dcpedit/midevil/pcb/README.md

# MidEvil PCB

midevil-pcb
