dcpedit/midevil/pcb/pcb.kicad_sch

## KiCad design pcb/pcb.kicad_sch (2023-09-18)

Schematic: pcb.kicad_sch

Parts:
D1, D2, D3, D4, D5, D6, D7, D8, D9, D10, D11, D12, D13, D14, D15, D16, D17, D18, D19, D20, D21, D22, D23, D24, D25, D26, D27, D28, D29, D30, D31, D32, D33, D34, D35, D36, D37, D38, D39, D40, D41, D42, D43, D44, D45, D46, D47, D48: BAV70; SOT-23_Handsoldering
J1: Conn_01x08_Socket
MX00, MX01, MX02, MX03, MX04, MX05, MX06, MX07, MX08, MX09, MX09.1, MX10, MX11, MX12, MX13, MX14, MX15, MX16, MX17, MX18, MX19, MX19.1, MX20, MX20.125, MX21, MX22, MX23, MX24, MX25, MX26, MX27, MX28, MX28.2, MX29, MX30, MX30.125, MX31, MX32, MX33, MX34, MX35, MX36, MX37, MX38, MX38.125, MX39, MX40, MX41, MX42, MX42.225, MX43, MX44, MX45, MX46, MX47, MX48, MX49, MX50, MX51, MX52, MX53, MX54, MX55, MX56, MX57, MX58, MX59, MX60, MX61, MX62, MX63, MX64, MX64.1, MX65, MX66, MX67, MX69, MX70, MX71, MX72, MX73, MX74, MX75, MX76, MX77, MX78, MX79, MX80, MX81, MX82, MX83, MX84, MX84.1, MX85, MX86, MX87, MX90, MX91, MX91.1, MX92, MX93, MX93.1, MX94, MX95, MX96, MX97: MX-NoLED; MXOnly-1U-NoLED
U1: Pico; RPi_Pico_SMD_TH

Connections:
+5V: J1.8, U1.40 (VBUS)
COL0: MX00.1 (COL), MX10.1 (COL), MX20.1 (COL), MX20.125.1 (COL), MX30.1 (COL), MX30.125.1 (COL), MX40.1 (COL), MX50.1 (COL), MX60.1 (COL), MX70.1 (COL), MX80.1 (COL), MX90.1 (COL), U1.32 (GPIO27_ADC1)
COL1: MX01.1 (COL), MX11.1 (COL), MX21.1 (COL), MX31.1 (COL), MX41.1 (COL), MX51.1 (COL), MX61.1 (COL), MX71.1 (COL), MX81.1 (COL), MX91.1 (COL), MX91.1.1 (COL), U1.34 (GPIO28_ADC2)
COL2: MX02.1 (COL), MX12.1 (COL), MX22.1 (COL), MX32.1 (COL), MX42.1 (COL), MX42.225.1 (COL), MX52.1 (COL), MX62.1 (COL), MX72.1 (COL), MX82.1 (COL), MX92.1 (COL), U1.15 (GPIO11)
COL3: MX03.1 (COL), MX13.1 (COL), MX23.1 (COL), MX33.1 (COL), MX43.1 (COL), MX53.1 (COL), MX63.1 (COL), MX73.1 (COL), MX83.1 (COL), MX93.1 (COL), MX93.1.1 (COL), U1.14 (GPIO10)
COL4: MX04.1 (COL), MX14.1 (COL), MX24.1 (COL), MX34.1 (COL), MX44.1 (COL), MX54.1 (COL), MX64.1 (COL), MX64.1.1 (COL), MX74.1 (COL), MX84.1 (COL), MX84.1.1 (COL), MX94.1 (COL), U1.12 (GPIO9)
COL5: MX05.1 (COL), MX15.1 (COL), MX25.1 (COL), MX35.1 (COL), MX45.1 (COL), MX55.1 (COL), MX65.1 (COL), MX75.1 (COL), MX85.1 (COL), MX95.1 (COL), U1.6 (GPIO4)
COL6: MX06.1 (COL), MX16.1 (COL), MX26.1 (COL), MX36.1 (COL), MX46.1 (COL), MX56.1 (COL), MX66.1 (COL), MX76.1 (COL), MX86.1 (COL), MX96.1 (COL), U1.5 (GPIO3)
COL7: MX07.1 (COL), MX17.1 (COL), MX27.1 (COL), MX37.1 (COL), MX47.1 (COL), MX57.1 (COL), MX67.1 (COL), MX77.1 (COL), MX87.1 (COL), MX97.1 (COL), U1.4 (GPIO2)
COL8: MX08.1 (COL), MX18.1 (COL), MX28.1 (COL), MX28.2.1 (COL), MX38.1 (COL), MX38.125.1 (COL), MX48.1 (COL), MX58.1 (COL), MX78.1 (COL), U1.2 (GPIO1)
COL9: MX09.1 (COL), MX09.1.1 (COL), MX19.1 (COL), MX19.1.1 (COL), MX29.1 (COL), MX39.1 (COL), MX49.1 (COL), MX59.1 (COL), MX69.1 (COL), MX79.1 (COL), U1.1 (GPIO0)
GND: J1.7, U1.3 (GND), U1.8 (GND), U1.13 (GND), U1.18 (GND), U1.23 (GND), U1.28 (GND), U1.38 (GND), U1.42 (GND)
LCD_CS: J1.6, U1.22 (GPIO17)
LCD_DC: J1.4, U1.21 (GPIO16)
LCD_LED: J1.1, U1.20 (GPIO15)
LCD_RST: J1.5, U1.19 (GPIO14)
LCD_SCK: J1.2, U1.24 (GPIO18)
LCD_SDA: J1.3, U1.25 (GPIO19)
unnamed: D1.1 (A), MX00.2 (ROW)
unnamed: D1.2 (A), MX01.2 (ROW)
unnamed: D2.1 (A), MX10.2 (ROW)
unnamed: D2.2 (A), MX11.2 (ROW)
unnamed: D3.1 (A), MX20.2 (ROW), MX20.125.2 (ROW)
unnamed: D3.2 (A), MX21.2 (ROW)
unnamed: D4.1 (A), MX30.2 (ROW), MX30.125.2 (ROW)
unnamed: D4.2 (A), MX31.2 (ROW)
unnamed: D5.1 (A), MX40.2 (ROW)
unnamed: D5.2 (A), MX41.2 (ROW)
unnamed: D6.1 (A), MX50.2 (ROW)
unnamed: D6.2 (A), MX51.2 (ROW)
unnamed: D7.1 (A), MX60.2 (ROW)
unnamed: D7.2 (A), MX61.2 (ROW)
unnamed: D8.1 (A), MX70.2 (ROW)
unnamed: D8.2 (A), MX71.2 (ROW)
unnamed: D9.1 (A), MX80.2 (ROW)
unnamed: D9.2 (A), MX81.2 (ROW)
unnamed: D10.1 (A), MX90.2 (ROW)
unnamed: D10.2 (A), MX91.2 (ROW), MX91.1.2 (ROW)
unnamed: D11.1 (A), MX02.2 (ROW)
unnamed: D11.2 (A), MX03.2 (ROW)
unnamed: D12.1 (A), MX12.2 (ROW)
unnamed: D12.2 (A), MX13.2 (ROW)
unnamed: D13.1 (A), MX22.2 (ROW)
unnamed: D13.2 (A), MX23.2 (ROW)
unnamed: D14.1 (A), MX32.2 (ROW)
unnamed: D14.2 (A), MX33.2 (ROW)
unnamed: D15.1 (A), MX42.2 (ROW), MX42.225.2 (ROW)
unnamed: D15.2 (A), MX43.2 (ROW)
unnamed: D16.1 (A), MX52.2 (ROW)
unnamed: D16.2 (A), MX53.2 (ROW)
unnamed: D17.1 (A), MX62.2 (ROW)
unnamed: D17.2 (A), MX63.2 (ROW)
unnamed: D18.1 (A), MX72.2 (ROW)
unnamed: D18.2 (A), MX73.2 (ROW)
unnamed: D19.1 (A), MX82.2 (ROW)
unnamed: D19.2 (A), MX83.2 (ROW)
unnamed: D20.1 (A), MX92.2 (ROW)
unnamed: D20.2 (A), MX93.2 (ROW), MX93.1.2 (ROW)
unnamed: D21.1 (A), MX04.2 (ROW)
unnamed: D21.2 (A), MX05.2 (ROW)
unnamed: D22.1 (A), MX14.2 (ROW)
unnamed: D22.2 (A), MX15.2 (ROW)
unnamed: D23.1 (A), MX24.2 (ROW)
unnamed: D23.2 (A), MX25.2 (ROW)
unnamed: D24.1 (A), MX34.2 (ROW)
unnamed: D24.2 (A), MX35.2 (ROW)
unnamed: D25.1 (A), MX44.2 (ROW)
unnamed: D25.2 (A), MX45.2 (ROW)
unnamed: D26.1 (A), MX54.2 (ROW)
unnamed: D26.2 (A), MX55.2 (ROW)
unnamed: D27.1 (A), MX64.2 (ROW), MX64.1.2 (ROW)
unnamed: D27.2 (A), MX65.2 (ROW)
unnamed: D28.1 (A), MX74.2 (ROW)
unnamed: D28.2 (A), MX75.2 (ROW)
unnamed: D29.1 (A), MX84.2 (ROW), MX84.1.2 (ROW)
unnamed: D29.2 (A), MX85.2 (ROW)
unnamed: D30.1 (A), MX94.2 (ROW)
unnamed: D30.2 (A), MX95.2 (ROW)
unnamed: D31.1 (A), MX06.2 (ROW)
unnamed: D31.2 (A), MX07.2 (ROW)
unnamed: D32.1 (A), MX16.2 (ROW)
unnamed: D32.2 (A), MX17.2 (ROW)
unnamed: D33.1 (A), MX26.2 (ROW)
unnamed: D33.2 (A), MX27.2 (ROW)
unnamed: D34.1 (A), MX36.2 (ROW)
unnamed: D34.2 (A), MX37.2 (ROW)
unnamed: D35.1 (A), MX46.2 (ROW)
unnamed: D35.2 (A), MX47.2 (ROW)
unnamed: D36.1 (A), MX56.2 (ROW)
unnamed: D36.2 (A), MX57.2 (ROW)
unnamed: D37.1 (A), MX66.2 (ROW)
unnamed: D37.2 (A), MX67.2 (ROW)
unnamed: D38.1 (A), MX76.2 (ROW)
unnamed: D38.2 (A), MX77.2 (ROW)
unnamed: D39.1 (A), MX86.2 (ROW)
unnamed: D39.2 (A), MX87.2 (ROW)
unnamed: D40.1 (A), MX96.2 (ROW)
unnamed: D40.2 (A), MX97.2 (ROW)
unnamed: D41.1 (A), MX08.2 (ROW)
unnamed: D41.2 (A), MX09.2 (ROW), MX09.1.2 (ROW)
unnamed: D42.1 (A), MX18.2 (ROW)
unnamed: D42.2 (A), MX19.2 (ROW), MX19.1.2 (ROW)
unnamed: D43.1 (A), MX28.2 (ROW), MX28.2.2 (ROW)
unnamed: D43.2 (A), MX29.2 (ROW)
unnamed: D44.1 (A), MX38.2 (ROW), MX38.125.2 (ROW)
unnamed: D44.2 (A), MX39.2 (ROW)
unnamed: D45.1 (A), MX48.2 (ROW)
unnamed: D45.2 (A), MX49.2 (ROW)
unnamed: D46.1 (A), MX58.2 (ROW)
unnamed: D46.2 (A), MX59.2 (ROW)
unnamed: D47.2 (A), MX69.2 (ROW)
unnamed: D48.1 (A), MX78.2 (ROW)
unnamed: D48.2 (A), MX79.2 (ROW)
ROW0: D1.3 (K), D11.3 (K), D21.3 (K), D31.3 (K), D41.3 (K), U1.9 (GPIO6)
ROW1: D2.3 (K), D12.3 (K), D22.3 (K), D32.3 (K), D42.3 (K), U1.11 (GPIO8)
ROW2: D3.3 (K), D13.3 (K), D23.3 (K), D33.3 (K), D43.3 (K), U1.17 (GPIO13)
ROW3: D4.3 (K), D14.3 (K), D24.3 (K), D34.3 (K), D44.3 (K), U1.29 (GPIO22)
ROW4: D5.3 (K), D15.3 (K), D25.3 (K), D35.3 (K), D45.3 (K), U1.26 (GPIO20)
ROW5: D6.3 (K), D16.3 (K), D26.3 (K), D36.3 (K), D46.3 (K), U1.7 (GPIO5)
ROW6: D7.3 (K), D17.3 (K), D27.3 (K), D37.3 (K), D47.3 (K), U1.10 (GPIO7)
ROW7: D8.3 (K), D18.3 (K), D28.3 (K), D38.3 (K), D48.3 (K), U1.16 (GPIO12)
ROW8: D9.3 (K), D19.3 (K), D29.3 (K), D39.3 (K), U1.31 (GPIO26_ADC0)
ROW9: D10.3 (K), D20.3 (K), D30.3 (K), D40.3 (K), U1.27 (GPIO21)

Notes on the sheet:
ISO Tilde
ESC
ISO Enter
ISO Pipe
